gbhug5a/7-Segment-Displays-Multiplex-by-Segment/Schematics/Alternate with HC4017 decoder.jpg

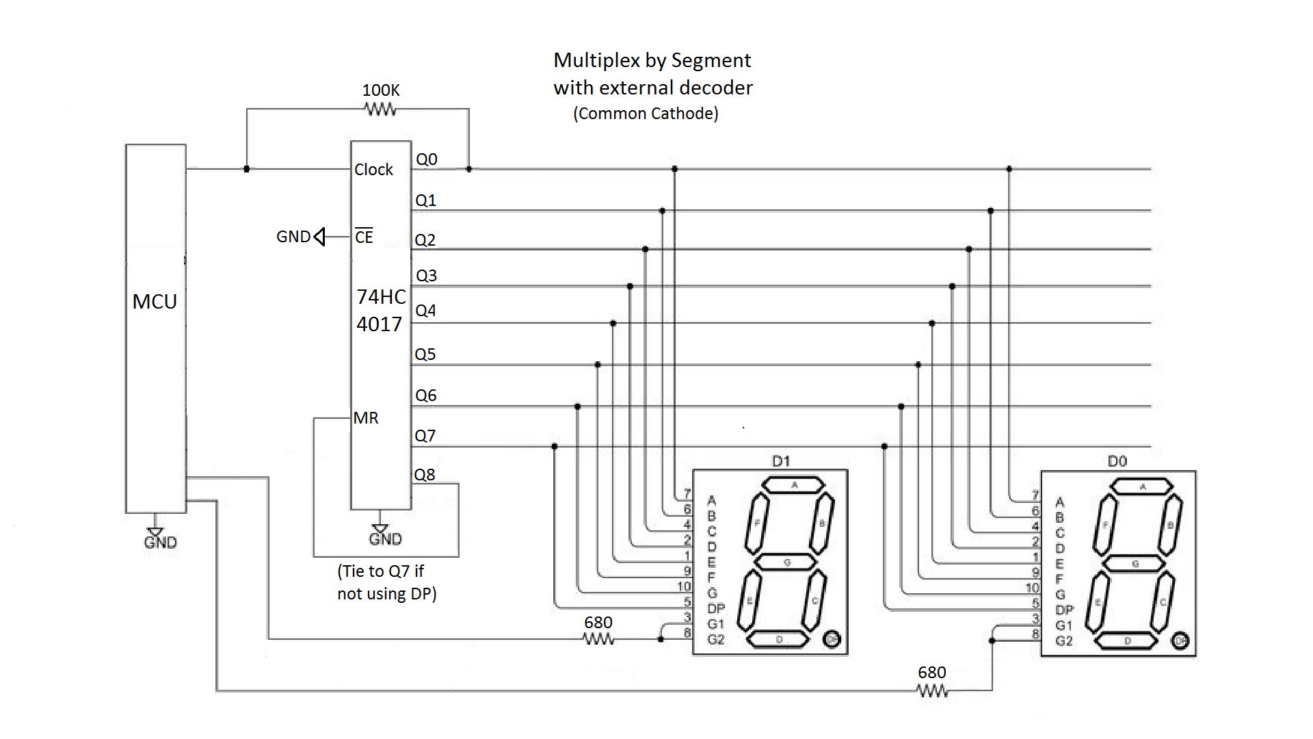
Schematics/Alternate with HC4017 decoder.jpg
