gbhug5a/7-Segment-Displays-Multiplex-by-Segment/Schematics/Alternate.jpg

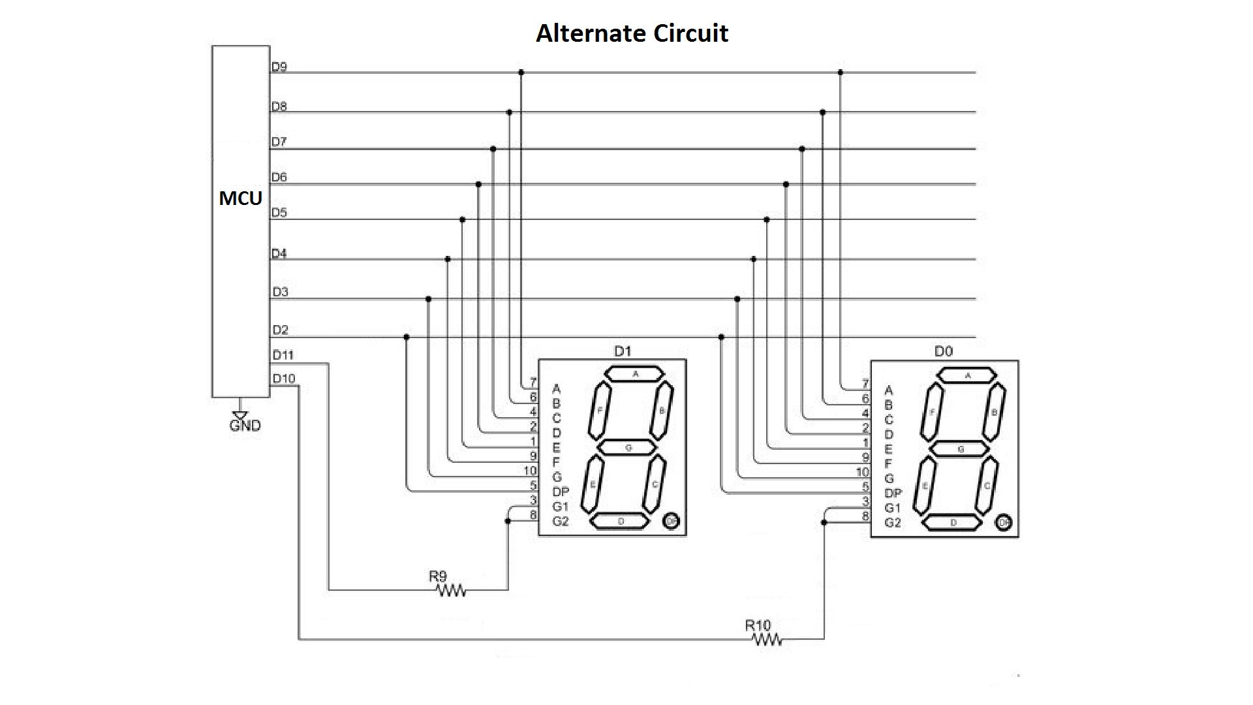
Schematics/Alternate.jpg
