gbhug5a/7-Segment-Displays-Multiplex-by-Segment/Schematics/Traditional.jpg

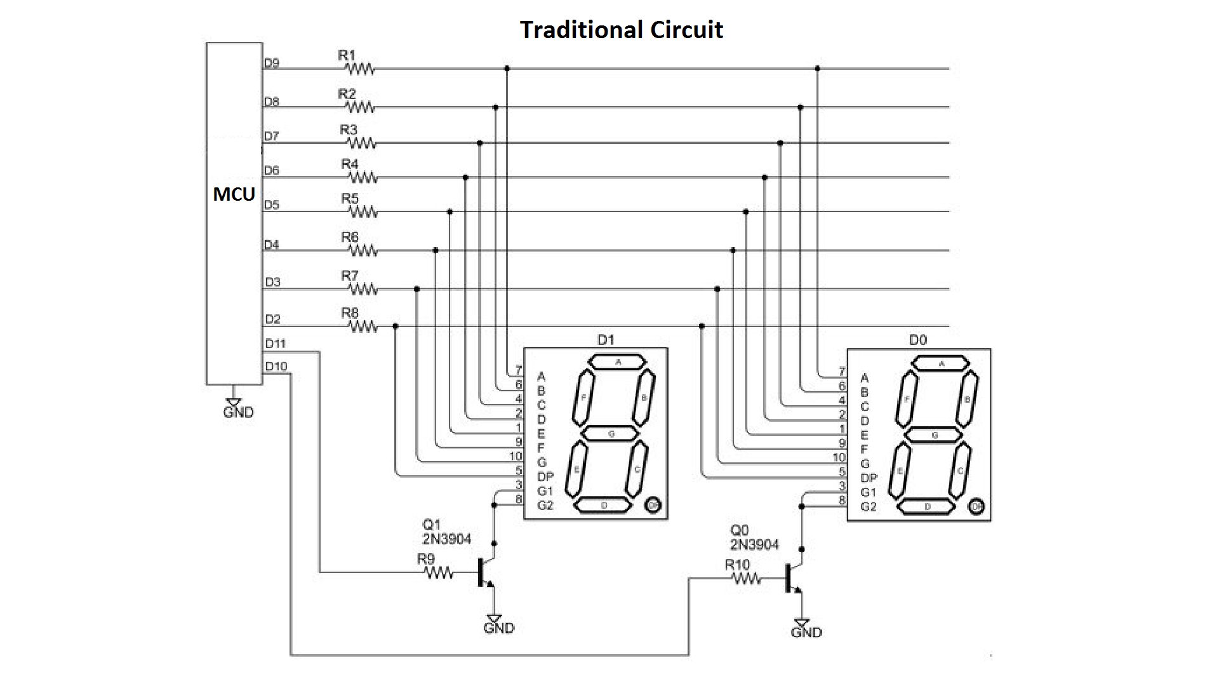
Schematics/Traditional.jpg
